Picatout/PocketSimon/documents/schematic.pdf

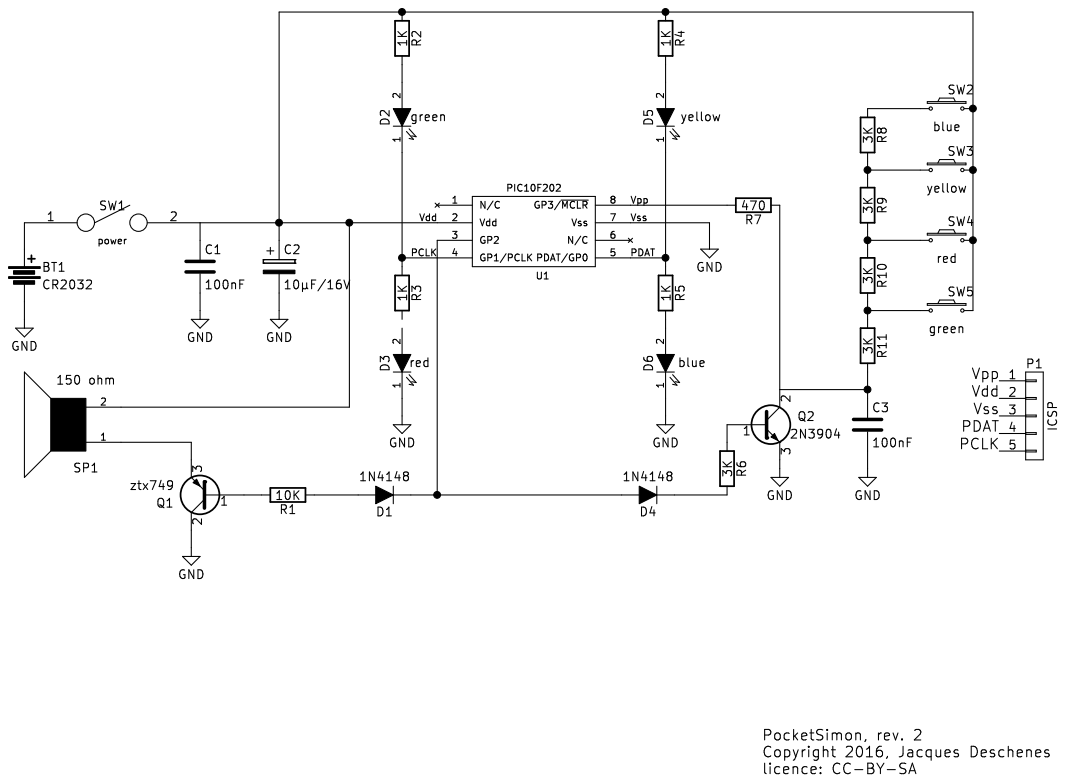
[picture p3: page 1]
