Picatout/PocketSimon/(commit log)

2017-01-01 change to schematic
    [pocketSimon.sch]
2017-01-02 modification to sofware and schematic
    [pocketSimon.sch]
2017-01-02 modfication to readme.md added board layout file.
2017-01-04 added notes.txt to keep track of optimization process. Saved 12 instrusctions up to now
